adafruit/Adafruit-DAC7578-Breakout-PCB/README.md

## Adafruit DAC7578 - 8 x Channel 12-bit I2C DAC - STEMMA QT / Qwiic PCB

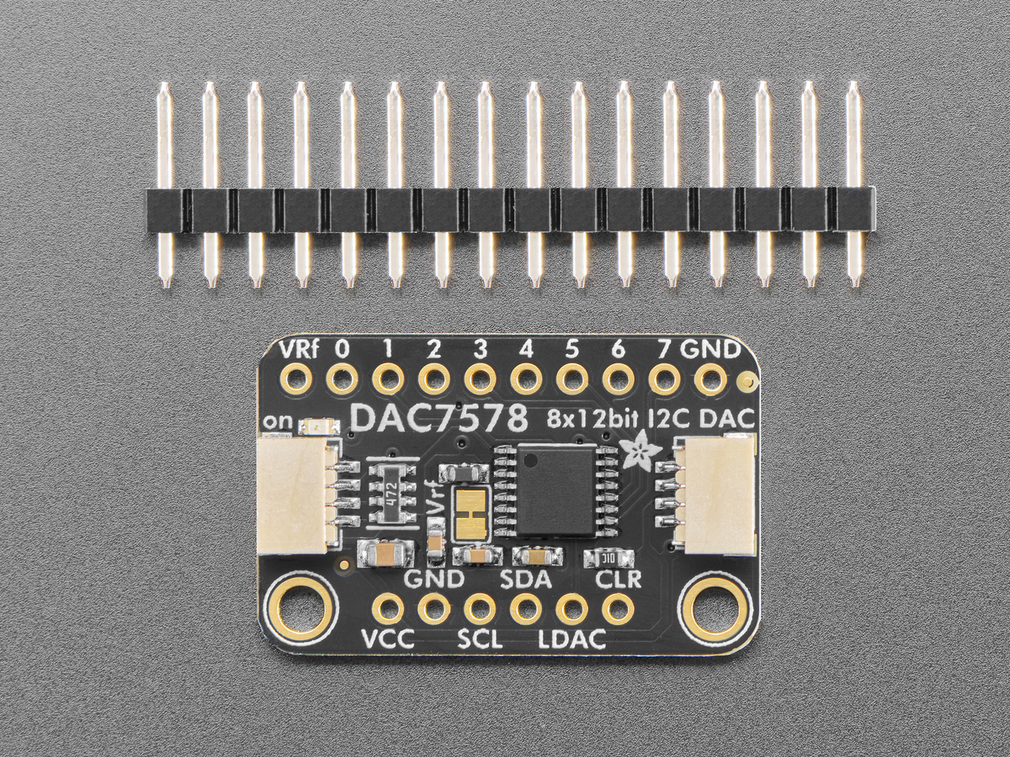
[picture p1: assets/6223.jpg]
<a href="http://www.adafruit.com/products/6223"><br/>
Click here to purchase one from the Adafruit shop</a>

PCB files for the Adafruit DAC7578 - 8 x Channel 12-bit I2C DAC - STEMMA QT / Qwiic. 

Format is EagleCAD schematic and board layout
* https://www.adafruit.com/product/6223

### Description

If you've ever said to yourself, "Gee, I wish I had eight 12-bit DACs that came in a single package", well I have good news. The Adafruit DAC7578 Breakout is the answer to your wishes! Within its little package, the DAC7578 has eight 12-bit DACs for whatever voltage setting needs you may have, easily controlled over I2C.

The DAC7578 can easily work with 3.3V or 5V power and logic so no matter what microcontroller / microcomputer you're using, you'll get full range output. Note that this DAC is 'ratiometric' - that means that 0 is ground and 4095 is whatever the Vref voltage is. By default the Vref is tied to the power pin, but you could cut a jumper to set the top voltage to anything between 0 and the power pin. E.g. if you want a precision 4.095V reference, you'll need to power with 5V, and provide 4.095V on the VRef pin.

The breakout for the DAC7578 is populated with the required support circuitry to use it with your microcontroller of choice or Blinka-supported computer. The SparkFun Qwiic compatible STEMMA QT JST SH connectors ease the process of connecting the DAC7578 to your project and allows you to easily share an I2C bus with other STEMMA QT, Qwiic, Grove, or other compatible sensors. QT Cable is not included, but we have a variety in the shop. 

Our drivers, wiring diagrams, and example code for Arduino, CircuitPython and Python make it easy to get started so you can get rolling with your project instead of figuring out how to wire things or get the code working.

### License

Adafruit invests time and resources providing this open source design, please support Adafruit and open-source hardware by purchasing products from [Adafruit](https://www.adafruit.com)!

Designed by Limor Fried/Ladyada for Adafruit Industries.

Creative Commons Attribution/Share-Alike, all text above must be included in any redistribution. 
See license.txt for additional details.
