adafruit/Adafruit-DAC7578-Breakout-PCB/Adafruit DAC7578P Breakout.brd

## EAGLE design Adafruit DAC7578P Breakout.brd (2025-02-14)

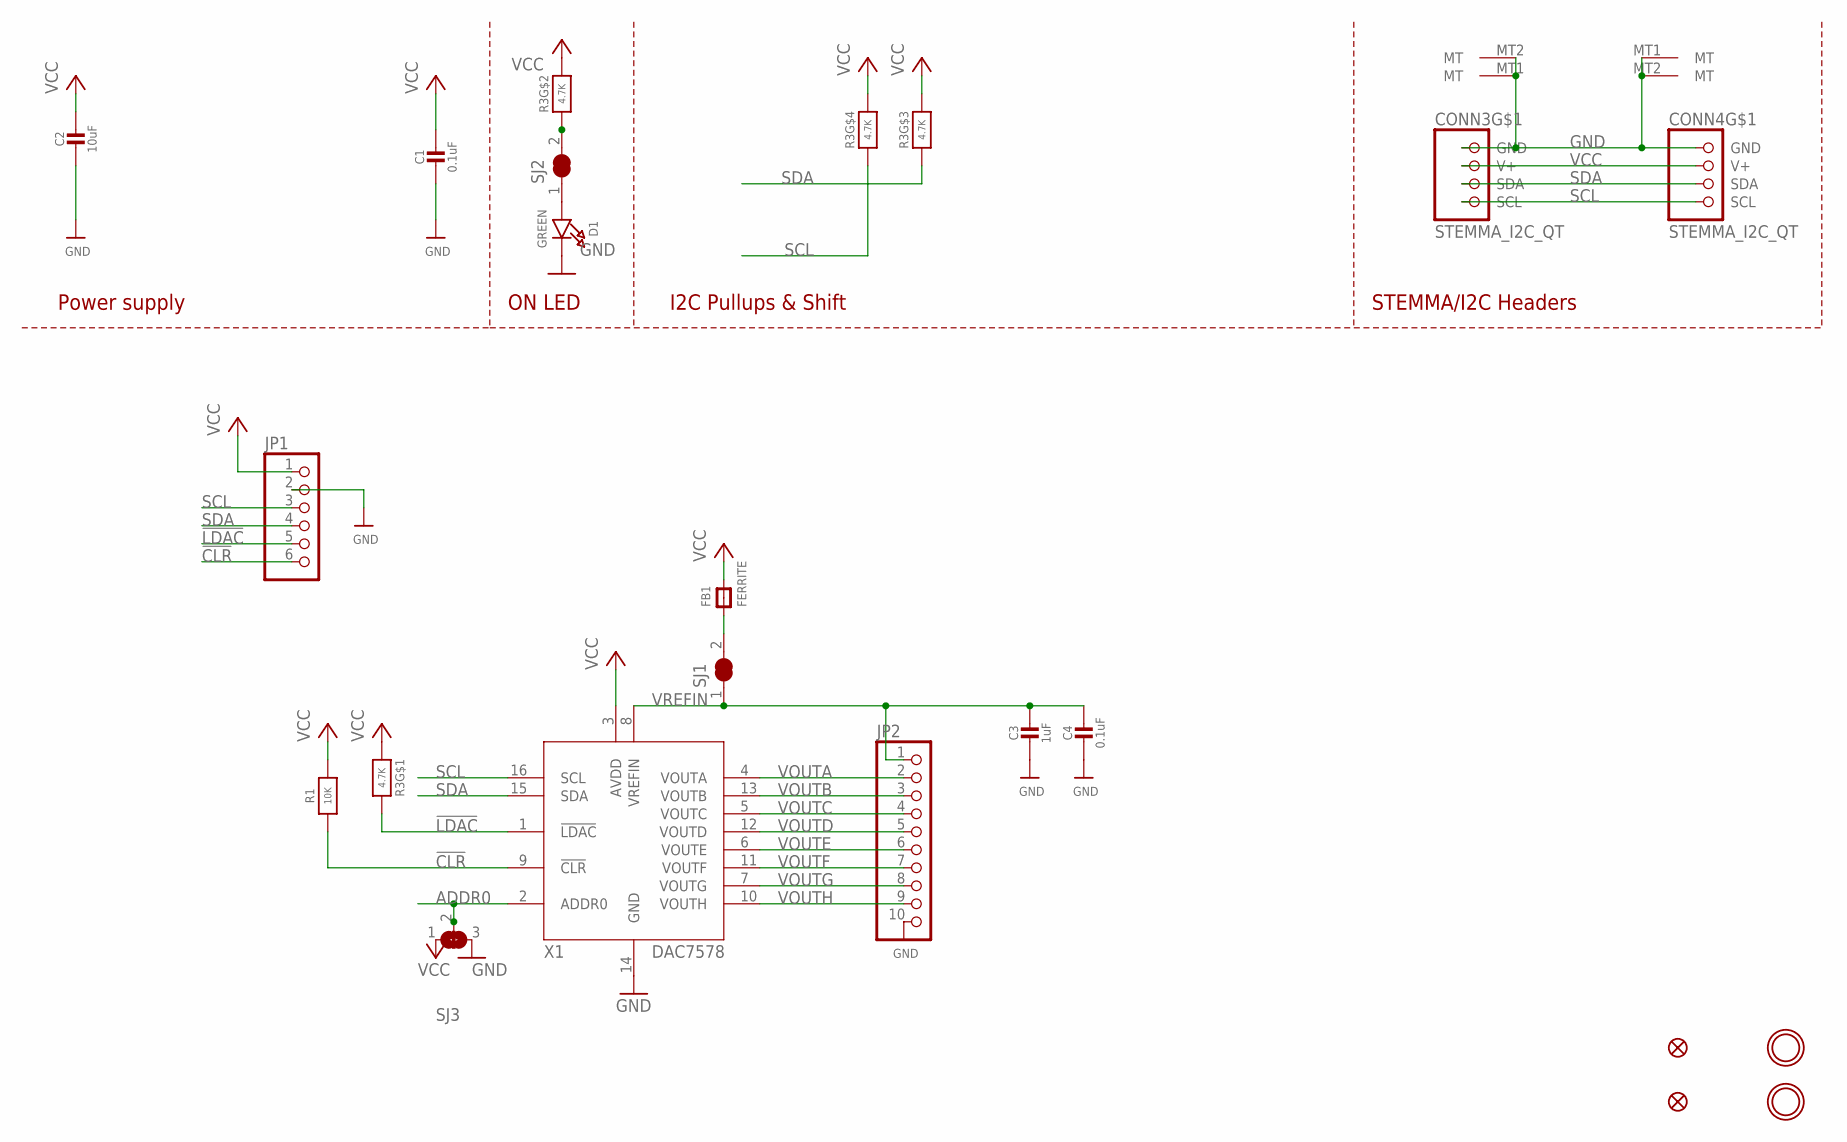
[picture p2: schematic Adafruit DAC7578P Breakout.sch]

Parts:
C1, C4: 0.1uF; 0603-NO
C2: 10uF; 0805-NO
C3: 1uF; 0603-NO
CONN3, CONN4: STEMMA_I2C_QT; JST_SH4
D1: GREEN; CHIPLED_0603_NOOUTLINE
FB1: FERRITE; 0603-NO
FID3, FID4: FIDUCIAL_0.5MM
JP1: HEADER-1X670MIL; 1X06_ROUND_70
JP2: HEADER-1X1070MIL; 1X10_ROUND70
R1: 10K; 0603-NO
R3: 4.7K; RESPACK_4X0603
SJ1, SJ2: SOLDERJUMPER_CLOSED; SOLDERJUMPER_CLOSEDWIRE
SJ3: SOLDERJUMPER_2WAY; SOLDERJUMPER_2WAY_OPEN_NOPASTE
U$19, U$21: MOUNTINGHOLE2.5; MOUNTINGHOLE_2.5_PLATED
X1: DAC7578PW; TSSOP16

Connections:
!CLR: JP1.6, R1.1, X1.9 (!CLR)
!LDAC: JP1.5, R3.8 (2), X1.1 (!LDAC)
ADDR0: SJ3.2, X1.2 (ADDR0)
GND: C1.2, C2.2, C3.2, C4.2, CONN3.1 (GND), CONN3.MT1 (MT), CONN3.MT2 (MT), CONN4.1 (GND), CONN4.MT1 (MT), CONN4.MT2 (MT), D1.C, JP1.2, JP2.10, SJ3.3, X1.14 (GND)
unnamed: R3.2 (1), SJ2.2
unnamed: FB1.1, SJ1.2
unnamed: D1.A, SJ2.1
SCL: CONN3.4 (SCL), CONN4.4 (SCL), JP1.3, R3.4 (1), X1.16 (SCL)
SDA: CONN3.3 (SDA), CONN4.3 (SDA), JP1.4, R3.3 (1), X1.15 (SDA)
VCC: C1.1, C2.1, CONN3.2 (V+), CONN4.2 (V+), FB1.2, JP1.1, R1.2, R3.1, R3.5 (2), R3.6 (2), R3.7 (2), SJ3.1, X1.3 (AVDD)
VOUTA: JP2.2, X1.4 (VOUTA)
VOUTB: JP2.3, X1.13 (VOUTB)
VOUTC: JP2.4, X1.5 (VOUTC)
VOUTD: JP2.5, X1.12 (VOUTD)
VOUTE: JP2.6, X1.6 (VOUTE)
VOUTF: JP2.7, X1.11 (VOUTF)
VOUTG: JP2.8, X1.7 (VOUTG)
VOUTH: JP2.9, X1.10 (VOUTH)
VREFIN: C3.1, C4.1, JP2.1, SJ1.1, X1.8 (VREFIN)

Notes on the sheet:
I2C Pullups & Shift
STEMMA/I2C Headers
ON LED
Power supply

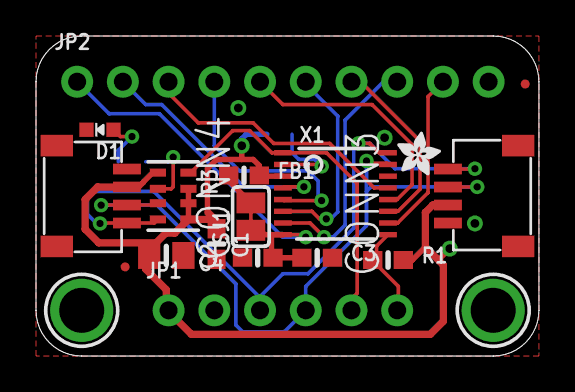
[picture p3: board Adafruit DAC7578P Breakout.brd from above]

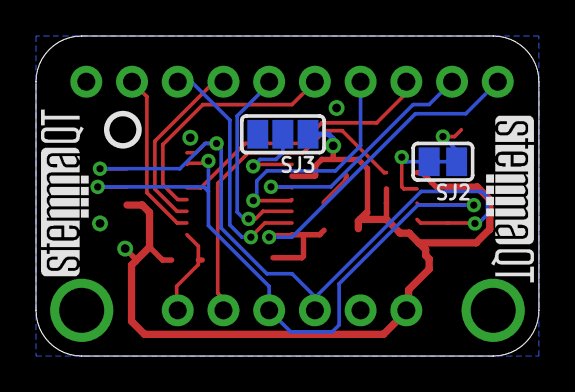
[picture p4: board Adafruit DAC7578P Breakout.brd from below]

Board: 2 copper layers, 27.9 x 17.8 mm, 50 parts (11 on the bottom side), 19 nets.

Other parts of the board:
PLABEL0: PLABEL0
PLABEL1: PLABEL1
PLABEL2: PLABEL2
PLABEL3: PLABEL3
PLABEL4: PLABEL4
PLABEL5: PLABEL5
PLABEL6: PLABEL6
PLABEL7: PLABEL7
PLABEL8: PLABEL8
PLABEL9: PLABEL9
PLABEL10: PLABEL10
PLABEL11: PLABEL11
PLABEL12: PLABEL12
PLABEL13: PLABEL13
PLABEL14: PLABEL14
PLABEL15: PLABEL15
PLABEL16: PLABEL16
PLABEL17: PLABEL17
PLABEL18: PLABEL18
PLABEL19: PLABEL19
PLABEL20: PLABEL20
PLABEL21: PLABEL21
PLABEL22: PLABEL22
PLABEL23: PLABEL23
PLABEL24: PLABEL24
PLABEL25: PLABEL25
U$4: ADAFRUIT_2.5MM
U$25: PCBFEAT-REV-040
U$30, U$31: STEMMAQT
